royxicer/ET2_test-test/PCB_Design/FR4_4-layers_1mm6_STACK.xlsx

Sheet: PLOECH
4-layer 搭叠， 表面处理化金5U”/镍150U”
 |  |  |  |  | SINGLE ENDED |  | EDGE COUPLED DEFFERENTIAL
Layer |  | Material | Thickness | ER | WIDTH | TARGET INPEDANCE | WIDTH | GAP | TARGET INPEDANCE
 |  | soldermask | 0.7 mil
L1 | TOP | Cu+Plating | 1.4 mil |  | 5.0 mil | 50 OHM | 4.0 mil | 7.0 mil | 100 OHM
 |  | FR4 | 3.1 mil
L2 | GND | Cu | 1.3 mil
 |  | FR4 | 50.0 mil
L3 | VCC | Cu | 1.3 mil
 |  | FR4 | 3.1 mil
L4 | BOTTOM | Cu+Plating | 1.4 mil |  | 5.0 mil | 50 OHM | 4.0 mil | 7.0 mil | 100 OHM
 |  | soldermask | 0.7 mil
 |  | Total thickness | 63.0 mil |  | 1.6mm +/- 10%
 |  |  | 1.6002

Sheet: Sheet1
8-layer 搭叠， 表面处理化金5U”/镍150U”
 |  |  |  | SINGLE ENDED |  | EDGE COUPLED DEFFERENTIAL
Layer |  | Material | Thickness | WIDTH | TARGET INPEDANCE | WIDTH | GAP | TARGET INPEDANCE
 |  | soldermask | 0.7 mil
L1 | TOP | Cu+Plating | 1.4 mil | 5 MIL | 50 OHM | 4.0 mil | 8 MIL | 100 OHM
 |  | FR4 | 3.2 mil
L2 | VCC1 | Cu | 1.2 mil
 |  | FR4 | 7.5 mil
L3 | SIG1 | Cu | 1.2 mil | 4.9 mil | 50 OHM | 4.0 mil | 8.0 mil | 100 OHM
 |  | FR4 | 7.5 mil
L4 | VCC2 | Cu | 1.2 mil
 |  | FR4 | 13.0 mil
L5 | GND | Cu | 1.2 mil
 |  | FR4 | 7.5 mil
L6 | SIG2 | Cu | 1.2 mil | 4.9 mil | 50 OHM | 4.0 mil | 8.0 mil | 100 OHM
 |  | FR4 | 7.5 mil
L7 | VCC3 | Cu | 1.2 mil
 |  | FR4 | 3.2 mil
L8 | BOTTOM | Cu+Plating | 1.4 mil | 5 MIL | 50 OHM | 4.0 mil | 8 MIL | 100 OHM
 |  | soldermask | 0.7 mil
 |  | Total thickness | 60.8 mil
4-layer 搭叠， 表面处理化金5U”/镍150U”
 |  |  |  | SINGLE ENDED |  | EDGE COUPLED DEFFERENTIAL
Layer |  | Material | Thickness | WIDTH | TARGET INPEDANCE | WIDTH | GAP | TARGET INPEDANCE
 |  | soldermask | 0.7 mil
L1 | TOP | Cu+Plating | 1.4 mil | 10 MIL | 50 OHM | 5.0 mil | 5.2 mil | 100 OHM
 |  | FR4 | 6.0 mil
L2 | GND | Cu | 1.2 mil
 |  | FR4 | 38.0 mil
L3 | VCC | Cu | 6.0 mil
 |  | FR4 | 6.0 mil
L4 | BOTTOM | Cu+Plating | 1.4 mil | 10 MIL | 50 OHM | 5.0 mil | 5.2 mil | 100 OHM
 |  | soldermask | 0.7 mil
 |  | Total thickness | 61.4 mil
