royxicer/ET2_test-test/PCB_Design/ET2_test Chip_PCB_Project_20210115/ET2_test Chip.PcbDoc.htm

Reporting Options

# File in Previous Format

Date | : | 6/2/2022
Time | : | 6:36:12 PM
Filename | : | D:\ET2_test Test\PCB_Design\ET2_test Chip_PCB_Project_20210115\ET2_test Chip.PcbDoc

Version | Warning

This file was generated by an earlier version of the software
