royxicer/ET2_test-test/TemperatureSensor_test/ET2_test_TemperatureSensor_test2.xlsx

Sheet: Sheet1
TempSetting | TS_testOUT4 | TS_OUT4 | TS_testOUT5 | TS_OUT5 | TS_testOUT6 | TS_OUT6 | TS_testOUT7 | TS_OUT7 | TS_testOUT8 | TS_OUT8 | PT100
25 | 0.5389 | 0.5441 | 0.6075 | 0.6141 | 0.5412 | 0.5459 | 0.567 | 0.5725 | 0.496 | 0.4999 | 109.599
30 | 0.5516 | 0.5566 | 0.6211 | 0.6275 | 0.5563 | 0.5615 | 0.5803 | 0.5858 | 0.5095 | 0.5133 | 111.726
35 | 0.565 | 0.5703 | 0.6354 | 0.6426 | 0.573 | 0.5782 | 0.5944 | 0.5997 | 0.5237 | 0.5275 | 113.991
40 | 0.5778 | 0.5831 | 0.6486 | 0.6557 | 0.5874 | 0.5925 | 0.608 | 0.6136 | 0.5375 | 0.5414 | 116.092
45 | 0.5864 | 0.5923 | 0.6395 | 0.6463 | 0.5807 | 0.5855 | 0.621 | 0.6268 | 0.5499 | 0.5536 | 118.15
50 | 0.6 | 0.6056 | 0.653 | 0.6599 | 0.5954 | 0.601 | 0.6344 | 0.6401 | 0.5634 | 0.5675 | 120.295
55 | 0.612 | 0.6177 | 0.6666 | 0.6734 | 0.6103 | 0.6154 | 0.6481 | 0.6535 | 0.5768 | 0.5811 | 122.326
60 | 0.6244 | 0.6301 | 0.6784 | 0.6852 | 0.6244 | 0.6298 | 0.661 | 0.6672 | 0.591 | 0.5949 | 124.463
65 | 0.6372 | 0.6431 | 0.6914 | 0.6983 | 0.638 | 0.6439 | 0.6742 | 0.6807 | 0.604 | 0.6082 | 126.574
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
