royxicer/ET2_test-test/(list of files, drawings)

Other design files:
PCB_Design/ET2_test Chip_PCB_Project_20210115/ET2_test Chip.PcbDoc
PCB_Design/ET2_test Chip_PCB_Project_20210115/ET2_test Chip.PrjPcb
PCB_Design/ET2_test Chip_PCB_Project_20210115/ET2_test Chip_V1.SchDoc
PCB_Design/ET2_test Chip_PCB_Project_20210115/ET2_test_Chip.SchDoc
