royxicer/ET2_test-test/I2C_Config_SEUTest/GBCR2_QC_Test_Control.py.py

import os
import sys
import visa
import time
# import labjack
# from u3 import *
from GBCR2_Reg import *
from usb_iss import UsbIss, defs
'''
@author: Wei Zhang
@date: August 8th, 2020
This python script is used to control the GBCR2 I2C slave.
'''
#=======================================================================================#
## Power Supply Control
# @param[in]: Instrument Handle
# @param[in]: Power Voltage input
# return: Channel_One_Current
def Power_Control(Inst, Channel_One_Volt):
    Inst.write("SOURce:VOLTage %.2f,(@1)"%(Channel_One_Volt))             # Channel One Power Voltage
    Channel_One_Current = round(float(Inst.query("MEAS:CURR? CH1"))*1000.0, 3)
    return Channel_One_Current
#=======================================================================================#
## Capture Screen Image
def Capture_Screen_Image(inst, Test_Mode, filename):
    inst.write("*CLS")                                      # Clear OSC Screen
    time.sleep(0.1)

    inst.write("DISplay:PERSistence:RESET")                 # Clear Persistence data
    time.sleep(0.01)
    inst.write("ACQuire:SAMPlingmode ET")                   # Acquire samplinng mode : Equivalent Time
    time.sleep(0.01)
    inst.write("TRIGGER:A:EDGE:SOURCE CH1")                 # set tirgger source and edge
    inst.write("HORIZONTAL:DELAY:MODE ON")                  # set Delay MODE
    inst.write("DISplay:PERSistence INFPersist")
    if Test_Mode == "Rx":
        inst.write("HORIZONTAL:DELAY:TIMe 2.734E-9")            # set Delay MODE

        inst.write("HORizontal:MODE:SCAle 200E-12")             # set horizontal scale

        inst.write("CH1:SCAle 5.0E-2")
        inst.write("HIStogram:MODe HORizontal")
        inst.write("HIStogram:SOUrce CH1")
        inst.write("HIStogram:DISplay LINEAr")
        inst.write("HIStogram:BOXPcnt 10, 49.5, 50, 50.5")
    else:
        inst.write("HORIZONTAL:DELAY:TIMe 21.875E-9")            # set Delay MODE

        inst.write("HORizontal:MODE:SCAle 1E-9")             # set horizontal scale

        inst.write("CH1:SCAle 7.0E-2")
        inst.write("HIStogram:MODe HORizontal")
        inst.write("HIStogram:SOUrce CH1")
        inst.write("HIStogram:DISplay LINEAr")
        inst.write("HIStogram:BOXPcnt 0, 49.5, 50, 50.5")

    # print(inst.query("CH1:SCAle?"))


    # inst.write("MASK:AUTOSet:HSCAle OFF")                  # Turn off Vertical scal
    # inst.write("MASK:AUTOSet:VSCAle OFF")                  # Turn off Vertical scal
    # inst.write("MASK:DISplay ON")                          # Turn off Vertical scal

    # inst.write("HIStogram:MODe HORizontal")
    # inst.write("HIStogram:SOUrce CH1")
    # inst.write("HIStogram:DISplay LINEAr")
    # inst.write("HIStogram:BOXPcnt 10, 49.5, 50, 50.5")

    inst.write("MEASUrement:MEAS1:SOUrce1 HIStogram")
    inst.write("MEASUREMENT:MEAS1:TYPE STDdev")

    inst.write("MEASUrement:MEAS2:SOUrce1 CH1")
    inst.write("MEASUREMENT:MEAS2:TYPE AMPlitude")

    inst.write("MEASUrement:MEAS3:SOUrce1 CH1")
    inst.write("MEASUREMENT:MEAS3:TYPE RISe")

    inst.write("MEASUrement:MEAS4:SOUrce1 CH1")
    inst.write("MEASUREMENT:MEAS4:TYPE FALL")

    # inst.write("MEASUrement:MEAS2:SOUrce1 HIStogram")
    # inst.write("MEASUREMENT:MEAS2:TYPE PK2Pk")


    inst.write("MEASUrement:MEAS1:STATE ON")                # display frequency measurement results
    inst.write("MEASUrement:MEAS2:STATE ON")                # display rising edge measurement results
    inst.write("MEASUrement:MEAS3:STATE ON")                # display frequency measurement results
    inst.write("MEASUrement:MEAS4:STATE ON")                # display rising edge measurement results
    time.sleep(10)

    RMS_Jitter = inst.query("MEASUREMENT:MEAS1:VALue?")
    Amplitude = inst.query("MEASUREMENT:MEAS2:VALue?")
    Rise = inst.query("MEASUREMENT:MEAS3:VALue?")
    Fall = inst.query("MEASUREMENT:MEAS4:VALue?")

    inst.write("EXPort:FORMat PNG")                         # set export image format
    inst.write("EXPort:VIEW FULLSCREEN")                    # view range
    inst.write("EXPort:PALEtte COLOr")                      # palette full color
    inst.write("EXPort:FILEName 'C:\\GBCR2_QC_Test\\%s.PNG'"%filename)      # file store desitination
    inst.write("EXPort STARt")                              # start exprot image
    # print(inst.query("EXPort?"))                            # query export destination
    return [RMS_Jitter, Amplitude, Rise, Fall]

#=======================================================================================#
## I2C write and Read
def I2C_Write_Read(GBCR2_Reg1, iss):
    slave_addr = 0x23
    reg_val = []
    reg_val = GBCR2_Reg1.get_config_vector()
    # print(reg_val)
    Error_type = "I2C ACK!!"
    I2C_Status = "Failed"
    try:
        iss.i2c.write(slave_addr, 0, reg_val)
    except:
        Error_type = "I2C NACK!!"
        print("I2C NACK!!\n")

    time.sleep(0.1)
    iic_read_reg = iss.i2c.read(slave_addr, 0, len(reg_val))
    print(reg_val)
    print(iic_read_reg)
    if Error_type != "I2C NACK!!":
        if reg_val == iic_read_reg:
            # print("Read back data matches with Write into data")
            I2C_Status = "Passed"
        else:
            # print("Read back data didn't matche with Write into data")
            I2C_Status = "Failed"
    return [I2C_Status, reg_val, iic_read_reg]

#=======================================================================================#
def main():
    IDD_Max = 180                           # Power Current max value
    IDD_Min = 45                            # Power Current min value
    I2C_Read_Times = 10
    Jitter_Max = 100                         # Jitter max values
    Rx_Amplitude_Min = 100                  # Amplitude min value
    Tx_Amplitude_Min = 200                  # Amplitude min value


    ## Input Parameters
    # Test_Mode = sys.argv[1]                 # Rx or Tx
    # Tester_Name = sys.argv[2]               # Tester Name
    # Chip_ID = sys.argv[3]                   # Chip id

    ## Power Supply
    # rm = visa.ResourceManager()
    # print(rm.list_resources())
    # Power_Inst = rm.open_resource('USB0::0x2A8D::0x1002::MY59001324::INSTR')    # connect to SOC
    # print(Power_Inst.query("*IDN?"))
    # Power_Inst.write("OUTPut:STATe ON,(@1)")                                          # Turn On Power Channel One

    # OSC_Inst = rm.open_resource('GPIB0::1::INSTR')                              # connect to SOC
    # print(OSC_Inst.query("*IDN?"))
    # OSC_Inst.write("*RST")                                                      # reset the OSC

    ## set usb-iss iic master device
    slave_addr = 0x23                                                           # iic target address
    iss = UsbIss()                                                              # usb-iss handle
    iss.open("COM5")                                                            # usb com EXPort
    iss.setup_i2c(clock_khz=100)                                                # i2c SCL clock frequency = 100 KHz, if set to 400 KHz, at 1.08 V NACK

    # ## Labjack instrument
    # d = U3()
    # # print(d.configU3())
    # # print(d.configIO())
    # d.setFIOState(5, state = 1)                                                 # default value 1
    # d.setFIOState(6, state = 1)                                                 # default value 1
    # d.setFIOState(7, state = 1)                                                 # default value 1

    GBCR2_Reg1 = GBCR2_Reg()
    GBCR2_Reg1.set_Tx1_Dis_DL_BIAS(0)
    GBCR2_Reg1.set_Tx2_Dis_DL_BIAS(0)

    
    loop_num = 0
    I2C_Status = "Failed"
    while(loop_num < I2C_Read_Times and I2C_Status == "Failed"):
        # print(loop_num)
        I2C_Status1 = I2C_Write_Read(GBCR2_Reg1, iss)
        I2C_Status = I2C_Status1[0]
        if I2C_Status == "Failed":
            print("I2C Test Failed  %d\n"%loop_num)
            print("Written values:\n")
            print("%d "% val for val in I2C_Status1[1])
            print("\n")
            print("Read values:\n")
            ## write iic write into data and read back data to file
        time.sleep(0.1)
        loop_num += 1
    if loop_num < I2C_Read_Times:
        print("I2C Test Passed  %d\n"%loop_num)
    else:
        print("I2C NACK!!!")
        print("I2C Test Failed  %d\n"%loop_num)
    ## write iic write into data and read back data to file



    # with open("C:/GBCR2_QC_Test/GBCR2_QC_Test_Results/GBCR2_QC_%s_Chip_ID=%s.txt"%(Test_Mode, Chip_ID), 'a+') as infile:
    #     time_stamp = time.strftime('%Y-%m-%d %H:%M:%S',time.localtime(time.time()))
    #     infile.write("\n")                                                      # add a blank row
    #     infile.write("%s\n"%time_stamp)                                         # write timestamp to file
    #     infile.write("%s\n"%Tester_Name)                                        # Tester name


    #     Channel_One_Current = Power_Control(Power_Inst, 1.277)                  # Set Power Voltage is about 1.2 V
    #     if Channel_One_Current < IDD_Min or Channel_One_Current > IDD_Max:
    #         print("IDD Failed!!!")
    #         IDD_Status = "IDD Failed!!!"
    #         infile.write("%s\n"%IDD_Status)                                        # Tester name
    #     else:
    #         IDD_Status = "IDD Passed"
    #     if IDD_Status == "IDD Passed":
    #         infile.write("VDD=%.3fV IDD=%.3fA\n"%(1.2, Channel_One_Current))        # read power current
    #         time.sleep(1)
    #         ## I2C write and read 10 times. if yes,
    #         loop_num = 0
    #         I2C_Status = "Failed"
    #         while(loop_num < I2C_Read_Times and I2C_Status == "Failed"):
    #             # print(loop_num)
    #             I2C_Status1 = I2C_Write_Read(GBCR2_Reg1, iss, infile)
    #             I2C_Status = I2C_Status1[0]
    #             if I2C_Status == "Failed":
    #                 infile.write("I2C Test Failed  %d\n"%loop_num)
    #                 infile.write("Written values:\n")
    #                 infile.writelines("%d "% val for val in I2C_Status1[1])
    #                 infile.write("\n")
    #                 infile.write("Read values:\n")
    #                 infile.writelines("%d "% val for val in I2C_Status1[2])
    #                 infile.write("\n")
    #                 ## write iic write into data and read back data to file
    #             time.sleep(0.1)
    #             loop_num += 1
    #         if loop_num < I2C_Read_Times:
    #             infile.write("I2C Test Passed  %d\n"%loop_num)
    #         else:
    #             print("I2C NACK!!!")
    #             infile.write("I2C Test Failed  %d\n"%loop_num)
    #             infile.writelines("%d "% val for val in I2C_Status1[1])
    #             infile.write("\n")
    #             infile.writelines("%d "% val for val in I2C_Status1[2])
    #             infile.write("\n")
    #             ## write iic write into data and read back data to file
    #         if I2C_Status == "Passed":
    #             Power_Volt = [1.277, 1.145, 1.411]
    #             # Power_Volt = [1.411]
    #             Power_Volt_Board = [1.2, 1.08, 1.32]
    #             Power_Volt_Name = ["VDD=1V20", "VDD=1V08", "VDD=1V32"]
    #             Channel_One_Current = []
    #             I2C_Status = []
    #             Rx_Jitter_Performance = []
    #             Tx_Jitter_Performance = []
    #             Rx_Amplitude_Performance = []
    #             Tx_Amplitude_Performance = []
    #             Rx_Amplitude = 150
    #             Tx_Amplitude = 250
    #             Rx_Jitter = 80
    #             Tx_Jitter = 80
    #             print(time.strftime('%Y-%m-%d %H:%M:%S',time.localtime(time.time())))
    #             for Volt in range(len(Power_Volt)):
    #                                                                          # chaneg power voltage
    #                 print("\n%.2fV Voltage Test......"%Power_Volt_Board[Volt])
    #                 Channel_One_Current += [Power_Control(Power_Inst, Power_Volt[Volt])]
    #                 print("Power Current: %.3f"%Channel_One_Current[Volt])
    #                 time.sleep(1)
    #                 I2C_Status += [I2C_Write_Read(GBCR2_Reg1, iss, infile)[0]]
    #                 print("I2C Status: %s"%I2C_Status[Volt])
    #                 infile.write("%.2fV Voltage Test:==============================================\n"%Power_Volt_Board[Volt])
    #                 infile.write("Power Current: %.3f\n"%Channel_One_Current[Volt])
    #                 infile.write("I2C Status: %s\n"%I2C_Status[Volt])
    #                 if Test_Mode == "Rx":                                                                   # test Rx channel
    #                     for Chan in range(7):
    #                         if (Rx_Amplitude > Rx_Amplitude_Min and Rx_Jitter < Jitter_Max) and (Tx_Amplitude > Tx_Amplitude_Min and Tx_Jitter < Jitter_Max):
    #                             print("Rx Channel %d is being tested!"%(Chan+1))
    #                             d.setFIOState(5, state = Chan & 0x1)
    #                             d.setFIOState(6, state = (Chan & 0x2) >> 1)
    #                             d.setFIOState(7, state = (Chan & 0x4) >> 2)
    #                             time.sleep(0.1)
    #                             Measure_Value = Capture_Screen_Image(OSC_Inst, Test_Mode, "Chip_ID=%s_RX_CH%d_%s_Eye-diagram_Img"%(Chip_ID, Chan+1, Power_Volt_Name[Volt]))
    #                             print(Measure_Value)
    #                             # print("\n")
    #                             infile.write("Rx Channel %d:######################\n"%(Chan+1))
    #                             infile.write("RMS Jitter: %.3f ps\n"%float(eval(Measure_Value[0])*1e12))
    #                             infile.write("Amplitude: %.3f mV\n"%float(eval(Measure_Value[1])*1e3))
    #                             infile.write("Rise Time: %.3f ps\n"%float(eval(Measure_Value[2])*1e12))
    #                             infile.write("Fall Time: %.3f ps\n"%float(eval(Measure_Value[3])*1e12))
    #                             Rx_Jitter_Performance += [eval(Measure_Value[0])*1e12]
    #                             Rx_Amplitude_Performance += [eval(Measure_Value[1])*1e3]
    #                             # Rx_Jitter_Performance += [float(Measure_Value[0].split("E")[0])]
    #                             # Rx_Amplitude_Performance += [float(Measure_Value[1].split("E")[0])]
    #                             Rx_Amplitude = min(Rx_Amplitude_Performance)
    #                             Rx_Jitter = max(Rx_Jitter_Performance)
    #                 else:                                                                                   # test Tx channel
    #                     for Chan in range(2):
    #                         if (Rx_Amplitude > Rx_Amplitude_Min and Rx_Jitter < Jitter_Max) and (Tx_Amplitude > Tx_Amplitude_Min and Tx_Jitter < Jitter_Max):
    #                             print("Tx Channel %d is being tested!"%(Chan+1))
    #                             d.setFIOState(5, state = Chan & 0x1)
    #                             d.setFIOState(6, state = (Chan & 0x2) >> 1)
    #                             d.setFIOState(7, state = (Chan & 0x4) >> 2)
    #                             time.sleep(0.1)
    #                             Measure_Value = Capture_Screen_Image(OSC_Inst, Test_Mode, "Chip_ID=%s_TX_CH%d_%s_Eye-diagram_Img"%(Chip_ID, Chan+1, Power_Volt_Name[Volt]))
    #                             print(Measure_Value)
    #                             # print("\n")
    #                             infile.write("Tx Channel %d:######################\n"%(Chan+1))
    #                             infile.write("RMS Jitter: %.3f ps\n"%float(eval(Measure_Value[0])*1e12))
    #                             infile.write("Amplitude: %.3f mV\n"%float(eval(Measure_Value[1])*1e3))
    #                             infile.write("Rise Time: %.3f ps\n"%float(eval(Measure_Value[2])*1e12))
    #                             infile.write("Fall Time: %.3f ps\n"%float(eval(Measure_Value[3])*1e12))
    #                             Tx_Jitter_Performance += [eval(Measure_Value[0])*1e12]
    #                             Tx_Amplitude_Performance += [eval(Measure_Value[1])*1e3]
    #                             Tx_Amplitude = min(Tx_Amplitude_Performance)
    #                             Tx_Jitter = max(Tx_Jitter_Performance)
    #             # print(Channel_One_Current)
    #             # print(max(Channel_One_Current))
    #             # print(min(Channel_One_Current))
    #             # print(I2C_Status)
    #             # print(Rx_Jitter_Performance)
    #             # print(Rx_Amplitude_Performance)
    #             # print(max(Rx_Jitter_Performance))
    #             # print(min(Rx_Amplitude_Performance))
    #             if max(Channel_One_Current) < IDD_Max and min(Channel_One_Current) > IDD_Min and ("Fail" in I2C_Status) == False:
    #                 if Test_Mode == "Rx":
    #                     if max(Rx_Jitter_Performance) < Jitter_Max and min(Rx_Amplitude_Performance) > Rx_Amplitude_Min:
    #                         print("Chip Test Passed")
    #                         infile.write("Chip Test Passed\n\n")
    #                     else:
    #                         print("Eye-Diagram didn't pass!!!")
    #                         infile.write("Eye-Diagram didn't pass!!!\n\n")
    #                 else:
    #                     if max(Tx_Jitter_Performance) < Jitter_Max and min(Tx_Amplitude_Performance) > Tx_Amplitude_Min:
    #                         print("Chip Test Passed")
    #                         infile.write("Chip Test Passed\n\n")
    #                     else:
    #                         print("Eye-Diagram didn't pass!!!")
    #                         infile.write("Eye-Diagram didn't pass!!!\n\n")
    #             else:
    #                 print("IID Failed!!!")

    #         infile.write("\n")

    # # ## Turn off Power
    # time.sleep(2)
    # Power_Inst.write("OUTPut:STATe OFF,(@1)")
    # print(time.strftime('%Y-%m-%d %H:%M:%S',time.localtime(time.time())))
    # d.setFIOState(5, state = 1)                                                 # default value 1
    # d.setFIOState(6, state = 1)                                                 # default value 1
    # d.setFIOState(7, state = 1)                                                 # default value 1

#=======================================================================================#
if __name__ == '__main__':
    main()
